pcesarjr/minicurso-robotica-afya/docs/slides/README.md

# Apresentações

| Arquivo | Slides | Conteúdo |
|---|---|---|
| [`parte1-arduino-passo-a-passo.pdf`](parte1-arduino-passo-a-passo.pdf) | 34 | Arduino, IDE, protoboard, resistores e as 10 etapas de montagem e teste. |
| [`parte2-robo-sentinela-ml.pdf`](parte2-robo-sentinela-ml.pdf) | 42 | Máquina de estados, Machine Learning (dados, features, árvore de decisão, avaliação, TinyML), integração e encerramento. |

As notas do apresentador (tempo, perguntas para a turma e erros comuns) estão na versão original das apresentações. Elas não aparecem neste PDF.
