pcesarjr/minicurso-robotica-afya/docs/diagramas/arduino.png

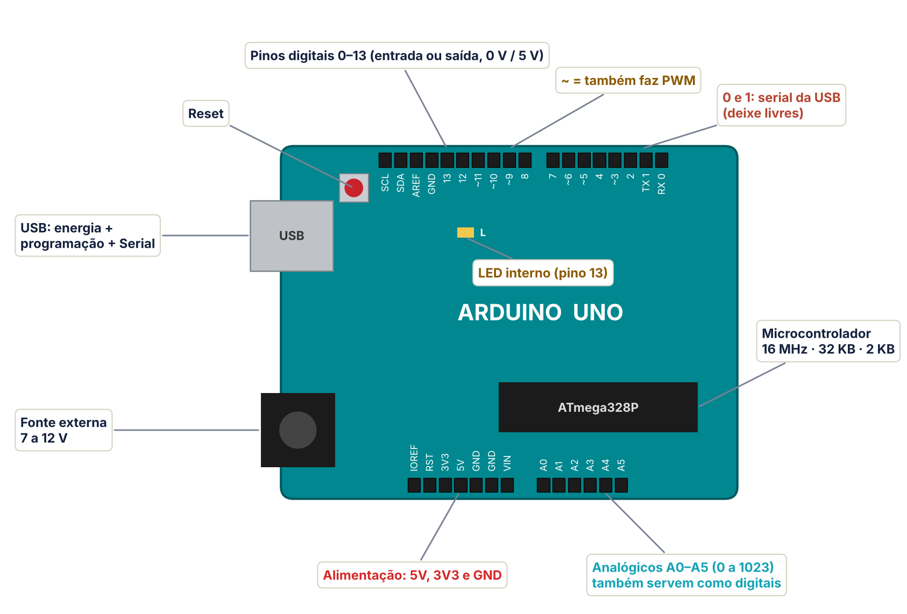
docs/diagramas/arduino.png
