pcesarjr/minicurso-robotica-afya/docs/diagramas/etapas/e0_alimentacao.png

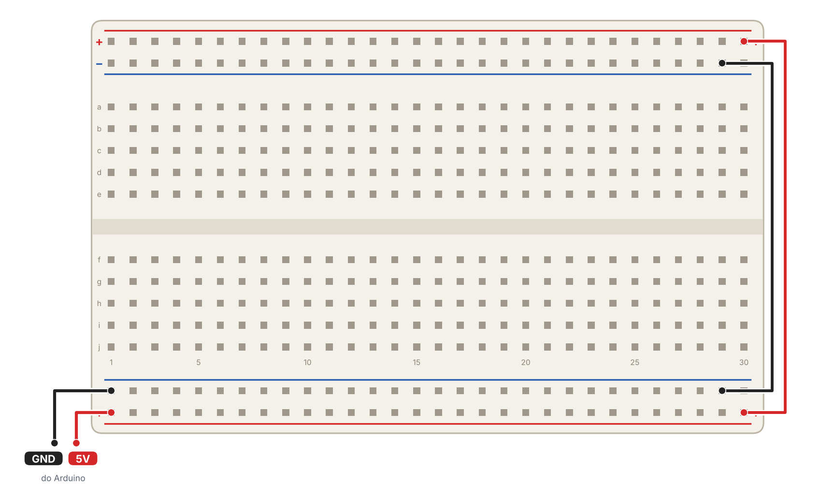
docs/diagramas/etapas/e0_alimentacao.png
