pcesarjr/minicurso-robotica-afya/docs/diagramas/etapas/e1_led.png

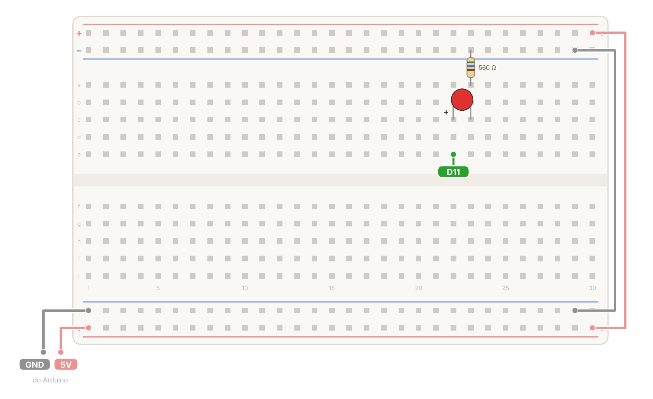
docs/diagramas/etapas/e1_led.png
