pcesarjr/minicurso-robotica-afya/docs/diagramas/etapas/e2_leds.png

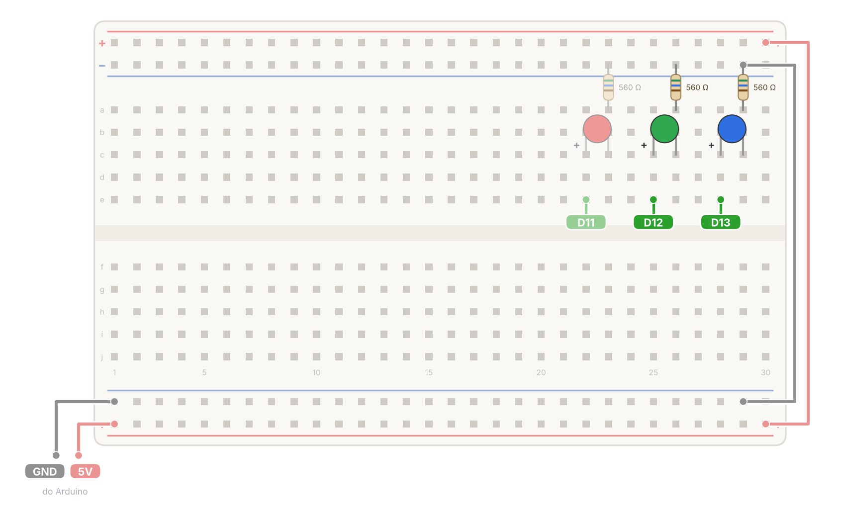
docs/diagramas/etapas/e2_leds.png
