pcesarjr/minicurso-robotica-afya/docs/diagramas/etapas/e5_ldr.png

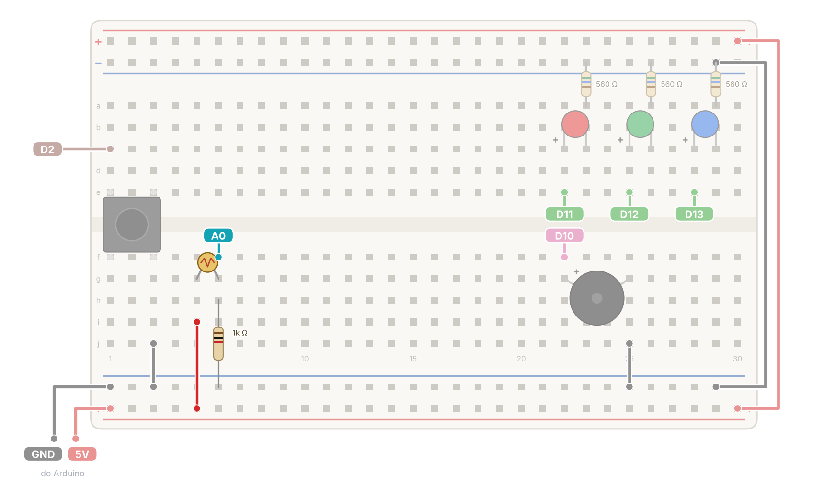
docs/diagramas/etapas/e5_ldr.png
