pcesarjr/minicurso-robotica-afya/docs/diagramas/etapas/e6_display.png

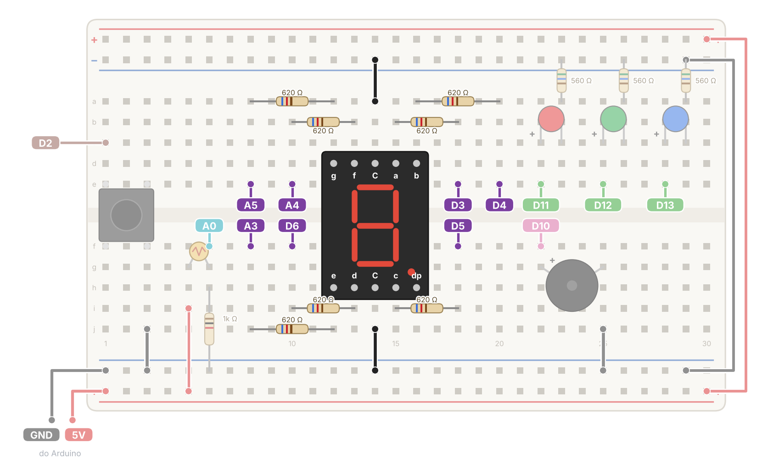
docs/diagramas/etapas/e6_display.png
