pcesarjr/minicurso-robotica-afya/docs/diagramas/etapas/e7_hcsr04.png

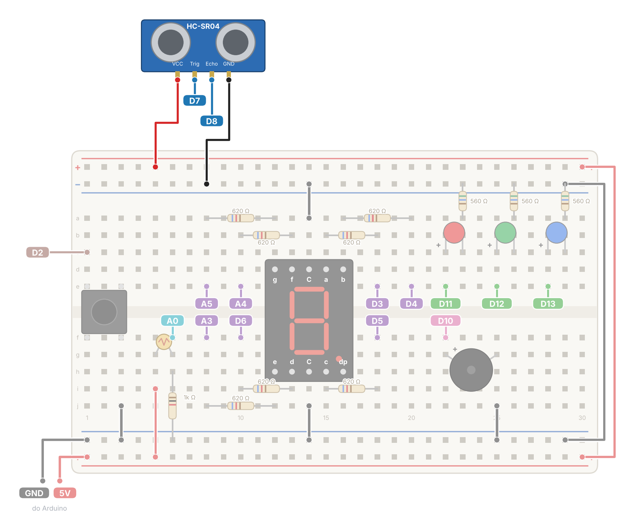
docs/diagramas/etapas/e7_hcsr04.png
