pcesarjr/minicurso-robotica-afya/docs/diagramas/etapas/e8_servo.png

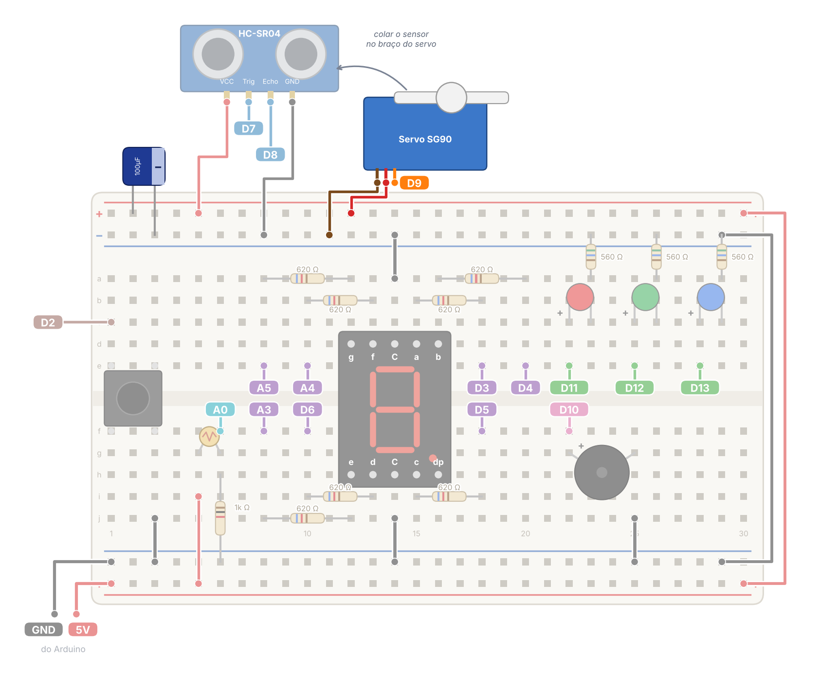
docs/diagramas/etapas/e8_servo.png
