pcesarjr/minicurso-robotica-afya/docs/diagramas/etapas/e9_rele.png

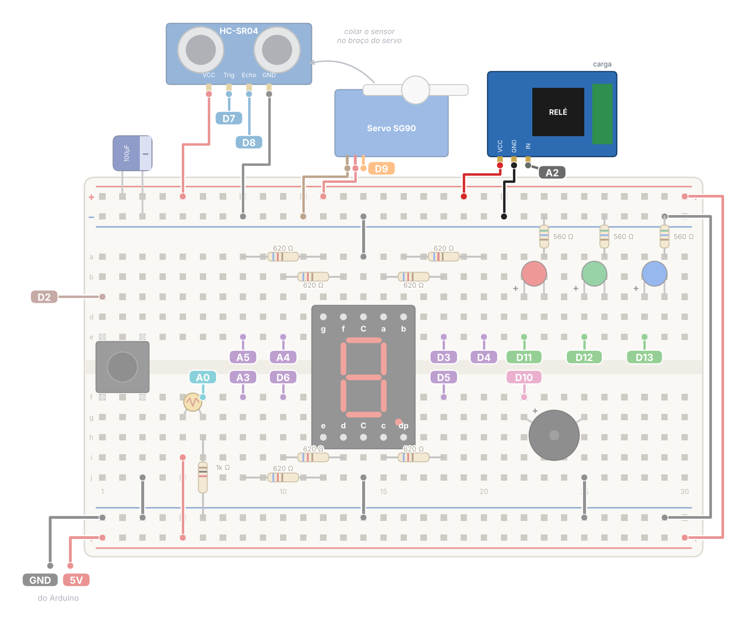
docs/diagramas/etapas/e9_rele.png
