pcesarjr/minicurso-robotica-afya/docs/diagramas/etapas/e10_completo.png

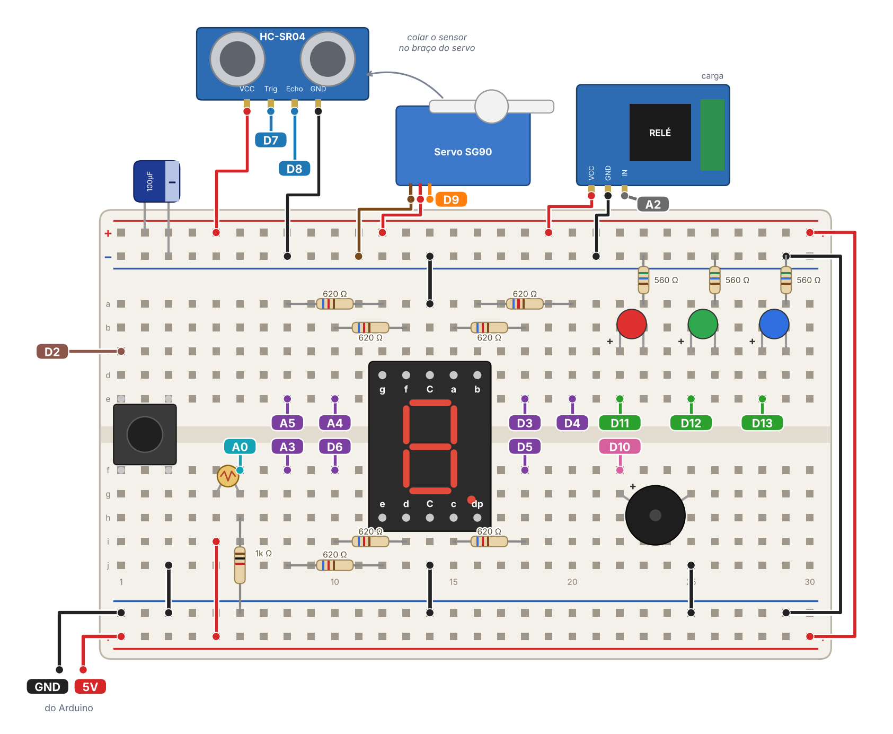
docs/diagramas/etapas/e10_completo.png
