pcesarjr/minicurso-robotica-afya/docs/diagramas/protoboard.png

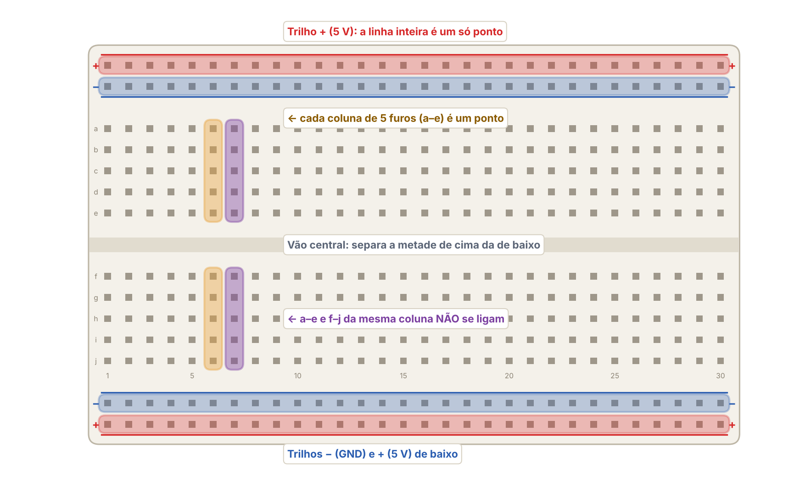
docs/diagramas/protoboard.png
