pcesarjr/minicurso-robotica-afya/(commit log)

2026-10-28 Minicurso de Robótica: Robô Sentinela com Machine Learning
    Parte 1 (Arduino passo a passo), Parte 2 (robô sentinela com ML),
    apostila, diagramas e ferramentas.
    Claude-Session: https://claude.ai/code/session_01FDKmhRg5M485SCzaWkfRMf
    [dados_exemplo_simulado.csv]
2026-10-28 Adiciona licenças: MIT para o código e CC BY 4.0 para o material didático
    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
